haocong99/DATN_NCH/Slide+word/Ảnh1.jpg

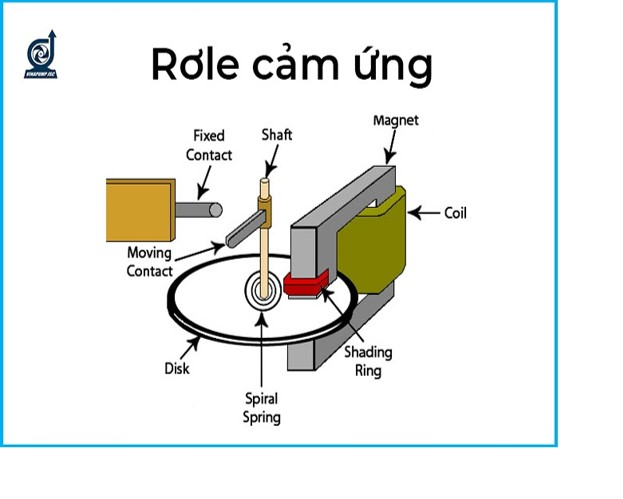
Slide+word/Ảnh1.jpg
