haocong99/DATN_NCH/Hardware/20211129_mach tren NCKH/20211129_mach tren NCKH.xlsx

Comment | Description | Designator | Footprint | LibRef | Quantity
470 | Res | 1, R20 | RES-SMD-0805 | Res | 2
470uf | Cap P 0,1uF < 22uF , 16 - 50V | C1, C2 | CP1/2 | CP1 | 2
104 |  | C3, C4, C5, C6, C7, C8, C9, cc3 | CN-SMD-0805 | CN | 8
470uF | Capacitor (Semiconductor SIM Model) | CAP 1 | CA-ALU-6.3R | CN-ALU-DIP | 1
223 |  | cc1, cc4, cc5, cc6, cc7 | CN-SMD-0805 | CN | 5
MACH HA AP | MACH HA AP | DC-DC | mach ha ap | MACH HA AP | 1
SW | Switch button 2 pin | down irms, select, up irms | SW1-DIP | SW2 | 3
Arduino DUE | Arduino MEGA2560 | DUE | Arduino MEGA2560 | Arduino Mega2560 | 1
10UH | Res | FERITE1 | RES-SMD-0805 | Res | 1
SHUNT1 | Header, 2-Pin | header1 | HED2 | Header 2_1 | 1
SHUNT2 | Header, 2-Pin | header2 | HED2 | Header 2_1 | 1
SHUNT3 | Header, 2-Pin | header3 | HED2 | Header 2_1 | 1
SHUNT4 | Header, 2-Pin | header4 | HED2 | Header 2_1 | 1
SHUNT5 | Header, 2-Pin | header5 | HED2 | Header 2_1 | 1
Header 2_1 | Header, 2-Pin | JP1, JP2, JP3, JP4, JP5 | HED2 | Header 2_1 | 5
LM358 | IC DUAL COMPARATOR | kenh 1, kenh 2, kenh 3, kenh 4, kenh 5, LM358 | DIP8 | LM393 | 6
LED |  | LED nguon | LED-0805-Blue | LED SMD | 1
LED |  | LED WiFi1 | LED-0805-Green | LED SMD | 1
JP7 PIN | JP7 PIN | NGAN MACH | JP7H | JP7 | 1
JP9 | WR-PHD 2.54 mm Angled Socket Header | Qua dong | JP9-D1C | JP9 | 1
1k | Res | R1, R3, R5, R7, R9, R11, R14, R15, R18, R22, R23, R25, R26, R29, R30, R38, R39, R44, R49, R54 | RES-SMD-0805 | Res | 20
10R | Res | R2, R4, R6, R8, R10 | RES-SMD-0805 | Res | 5
10K | Res | R12, R13, R16 | RES-SMD-0805 | Res | 3
2k | Res | R17, R34, R40, R45, R50 | RES-SMD-0805 | Res | 5
9K | Res | R19, R24, R27, R28, R31 | RES-SMD-0805 | Res | 5
5.1k | Res | R21, R35, R41, R46, R51 | RES-SMD-0805 | Res | 5
2.7k | Res | R32, R36, R42, R47, R52 | RES-SMD-0805 | Res | 5
1.1k | Res | R33, R37, R43, R48, R53 | RES-SMD-0805 | Res | 5
PC817 | Single Opto | RESET | DIP4 | PC817 | 1
SW | Switch button 2 pin | SW1, SW2, SW3, SW4, SW5, SW6, SW7, SW8, SW9, SW10, SW11, SW12, SW13, SW14, SW15, SW16, SW17, SW18, SW19, SW20 | SW-DIP1-1 | SW2 | 20
10K | Var Resistor | VR1 | VR1 | VR | 1
