haocong99/DATN_NCH/(list of files, drawings)

Other design files:
Hardware/20211127_mach duoi NCKH/20211127_mach duoi NCKH.PrjPcb
Hardware/20211127_mach duoi NCKH/20211127_mach duoi NCKH.SchDoc
Hardware/20211127_mach duoi NCKH/in.PcbDoc
Hardware/20211129_mach tren NCKH/20211129_mach tren NCKH.PrjPcb
Hardware/20211129_mach tren NCKH/20211129_mach tren NCKH.SchDoc
Hardware/20211129_mach tren NCKH/in.PcbDoc
